ESETP/hyasynth-pcb/hyasynth/hyasynth.kicad_pcb

## KiCad design hyasynth/hyasynth.kicad_pcb (2024-02-29)

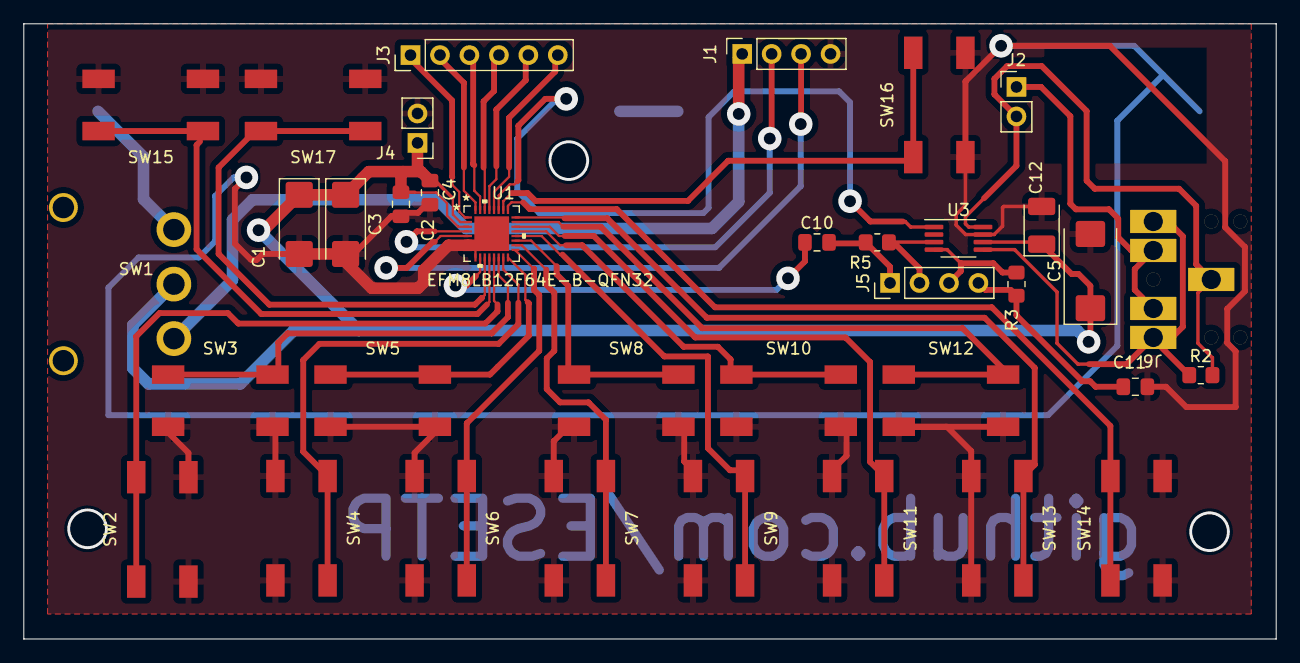
[picture p1: board hyasynth.kicad_pcb from above]

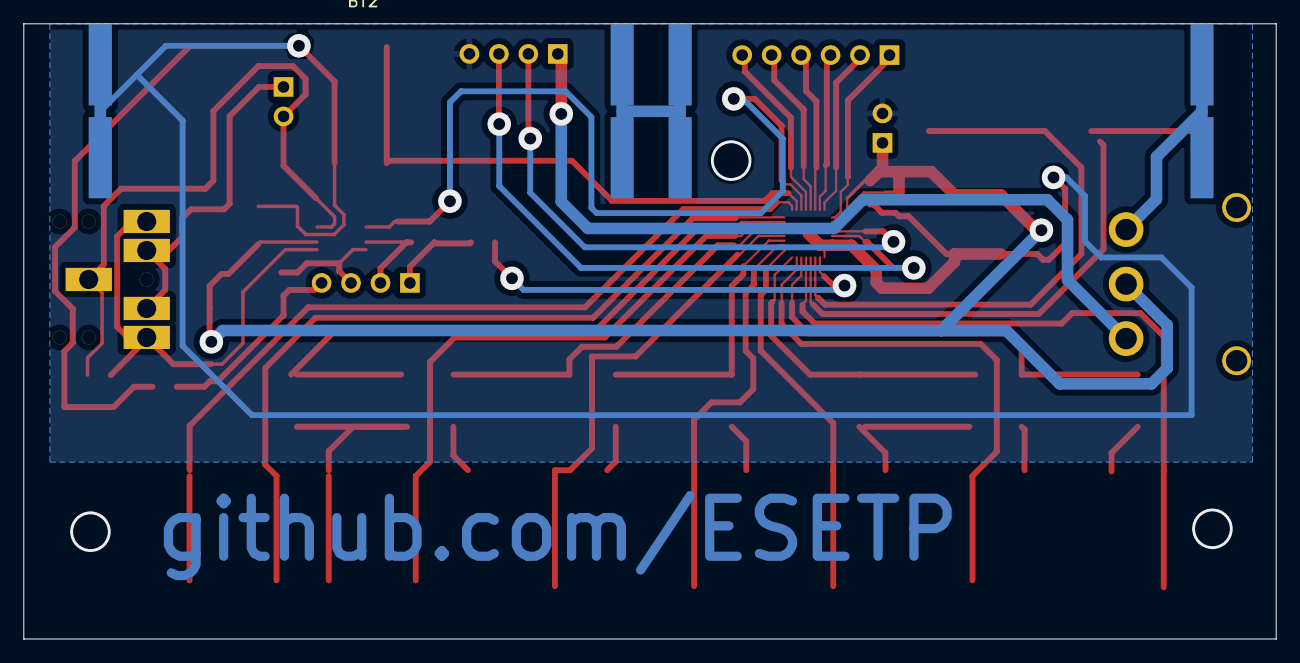
[picture p2: board hyasynth.kicad_pcb from below]

Board: 2 copper layers, 108.0 x 53.0 mm, 38 parts (2 on the bottom side), 38 nets.

Parts:
BT1, BT2: Battery_Cell; Battery AAA
C1, C3: 4.7u; CP_EIA-6032-28_Kemet-C_Pad2.25x2.35mm_HandSolder
C2, C4, C10, C11: 0.1u; C_0805_2012Metric_Pad1.18x1.45mm_HandSolder
C5: 10u; CP_EIA-7343-31_Kemet-D_Pad2.25x2.55mm_HandSolder
C12: 1u; CP_EIA-3528-12_Kemet-T_Pad1.50x2.35mm_HandSolder
J1: Conn_01x04_Male; PinSocket_1x04_P2.54mm_Vertical
J2, J4: Conn_01x02_Male; PinHeader_1x02_P2.54mm_Vertical
J3: Conn_01x06_Male; PinHeader_1x06_P2.54mm_Vertical
J5: Conn_01x04_Male; PinHeader_1x04_P2.54mm_Vertical
J6: AudioJack3_SwitchTR; Jack
R2: 8; R_0805_2012Metric_Pad1.20x1.40mm_HandSolder
R3, R5: R; R_0805_2012Metric_Pad1.20x1.40mm_HandSolder
SW1: Power Switch; Slide Switch
SW2: Low C; SW_Push_hand_solder
SW3: C# Db; SW_Push_hand_solder
SW4: D; SW_Push_hand_solder
SW5: D# Eb; SW_Push_hand_solder
SW6: E; SW_Push_hand_solder
SW7: F; SW_Push_hand_solder
SW8: F# Gb; SW_Push_hand_solder
SW9: G; SW_Push_hand_solder
SW10: G# Ab; SW_Push_hand_solder
SW11: A; SW_Push_hand_solder
SW12: A# Bb; SW_Push_hand_solder
SW13: B; SW_Push_hand_solder
SW14: C; SW_Push_hand_solder
SW15: Down Octave; SW_Push_hand_solder
SW16: Function; SW_Push_hand_solder
SW17: Up Octave; SW_Push_hand_solder
U1: EFM8LB12F64E-B-QFN32
U3: PAM8302AAD; MSOP-8_3x3mm_P0.65mm

Connections:
/A: SW11.2, U1.22 (P1-3)
/A#: SW12.2, U1.23 (P1-2)
/AMP_OUT+: J6.2 (R), J6.5 (T), R2.1, U3.5 (OUT+)
/AMP_OUT-: J2.2, J6.1 (S), R2.2, U3.8 (OUT-)
/AMP_SD: U1.27 (P0-6), U3.1 (~SD)
/B: SW13.2, U1.24 (P1-1)
/C: SW14.2, U1.25 (P1-0)
/C2CLK: J1.2, U1.4 (RSTB/C2CK)
/C2D: J1.3, U1.5 (P3-7/C2D)
/C#: SW3.2, U1.14 (P2-3)
/D: SW4.2, U1.15 (P2-2)
/D#: SW5.2, U1.16 (P2-1)
/DAC: C10.1, U1.10 (P3-0)
/Debug_Power: J1.1, SW1.1 (A)
/Down: SW15.2, U1.12 (P2-5)
/E: SW6.2, U1.17 (P2-0)
/F: SW7.2, U1.18 (P1-7)
/F#: SW8.2, U1.19 (P1-6)
/Function: SW16.2, U1.26 (P0-7)
/G: SW9.2, U1.20 (P1-5)
/G#: SW10.2, U1.21 (P1-4)
/GPIO_1: J3.4, U1.30 (P0-3)
/GPIO_2: J3.3, U1.31 (P0-2)
/GPIO_3: J3.2, U1.32 (P0-1)
/GPIO_4: J3.1, U1.1 (P0-0)
/Low_C: SW2.2, U1.13 (P2-4)
/SPK_OUT-: J2.1, J6.3 (RN), J6.4 (Tn)
/Uart_RX: J3.6, U1.28 (P0-5)
/Uart_TX: J3.5, U1.29 (P0-4)
/Up: SW17.2, U1.11 (P2-6)
/V_pot_in: C10.2, J5.1, R5.1
/V_pot_minus_in: C11.2, J5.4, R3.1
/V_pot_minus_out: J5.3, R3.2, U3.4 (IN-)
/V_pot_out: J5.2, R5.2, U3.3 (IN+)
GND: BT2.2 (-), C1.2, C2.2, C3.2, C4.2, C5.2, C11.1, C12.2, J1.4, J4.2, SW2.1, SW3.1, SW4.1, SW5.1, SW6.1, SW7.1, SW8.1, SW9.1, SW10.1, SW11.1, SW12.1, SW13.1, SW14.1, SW15.1, SW16.1, SW17.1, U1.6 (P3-4), U1.7 (P3-3), U1.8 (P3-2), U1.9 (P3-1), U1.33 (EPAD), U3.7 (GND)
unnamed: BT1.1 (+), SW1.3 (C)
unnamed: BT1.2 (-), BT2.1 (+)
VDD: C1.1, C2.1, C3.1, C4.1, C5.1, C12.1, J4.1, SW1.2 (B), U1.2 (VIO), U1.3 (VDD), U3.6 (VDD)
