ESETP/hyasynth-pcb/(commit log)

2022-01-12 Added Kicad project
    [hyasynth.kicad_pcb, hyasynth.kicad_sch]
2022-01-20 started schematic, micro, power placed, started rst/flashing
    [hyasynth.kicad_sch]
2022-01-22 Added Keybaord to schematic
    [hyasynth.kicad_sch]
2022-01-22 Neatened up schematic
    [hyasynth.kicad_sch]
2022-01-22 Attached footprints to most things
    [hyasynth.kicad_sch]
2022-01-25 Made changes to the schematic to fix bugs
    [hyasynth.kicad_sch]
2022-01-25 Power Amplifier for speaker output
    [hyasynth.kicad_sch]
2022-01-27 Added a jumper
    [hyasynth.kicad_sch]
2022-01-27 Added GPIO and LED
    [hyasynth.kicad_sch]
2022-01-27 Finished inital schematic design, added second amp, rearranged pins
    [hyasynth.kicad_sch]
2022-02-03 Definatly Borked
    [hyasynth.kicad_pcb, hyasynth.kicad_sch]
2022-02-03 Complete Footprint
    [hyasynth.kicad_sch]
2022-02-03 Footprint corrected
    [hyasynth.kicad_pcb, hyasynth.kicad_sch]
2022-02-03 started laying out pcb
    [hyasynth.kicad_pcb, hyasynth.kicad_sch]
2022-02-03 Did very little work
    [hyasynth.kicad_pcb]
2022-02-08 set battery positions, adjusted for caps
    [hyasynth.kicad_pcb, hyasynth.kicad_sch]
2022-02-10 laid out switches, started routing them.
    [hyasynth.kicad_pcb, hyasynth.kicad_sch]
2022-02-24 wired in switches and dac mostly
    [hyasynth.kicad_pcb]
2022-03-10 finished pcb v1
    [hyasynth.kicad_pcb]
2022-03-10 final first draft I swear
    [hyasynth.kicad_pcb]
2022-03-31 Footprint table
2022-03-31 New Footprints
2022-03-31 borrowed new button footprint
    [hyasynth.kicad_pcb, hyasynth.kicad_sch]
2022-04-01 Added jack and switch and repositioned components
    [hyasynth.kicad_pcb, hyasynth.kicad_sch]
2022-04-07 Added thermal relief to battery pads
2022-04-07 Assembly Instructions
2022-04-18 Finished Basic Revision of PCB
    [hyasynth.kicad_pcb, hyasynth.kicad_sch]
2022-04-18 Small changes to the direction tracks are going out from ICs in
    [hyasynth.kicad_pcb]
2022-04-18 Fixed GND via keepout
    [hyasynth.kicad_pcb]
2022-04-19 Schematic Changes
    [hyasynth.kicad_sch]
2022-04-21 Removed Three Vias
    [hyasynth.kicad_pcb]
2022-04-21 Change Footprint for Button
2022-04-21 Change Footprint for Jack and Switch
2022-04-21 tweaks for printing
    [hyasynth.kicad_pcb, hyasynth.kicad_sch]
2022-04-21 updated for new footprints
    [hyasynth.kicad_pcb]
2022-05-17 added headphone resistor, moved amp SD pin, tweak hole size
    [hyasynth.kicad_pcb, hyasynth.kicad_sch]
2022-05-17 added github link to copper
    [hyasynth.kicad_pcb]
2022-05-20 Update AssemblyInstructions.md
    Switched via and resistors and caps position as its easy to bridge power and ground under a cap, which is hard to find with the vias in
2022-05-24 changed link to github not website
    [hyasynth.kicad_pcb]
2024-02-29 Make suitable for fabrication
    - Add load resistor across amp output
    - Add resistor values for amp input
    - Convert edge cuts for drill holes to actual holes
    - Remove debug pad under speaker
    [hyasynth.kicad_pcb, hyasynth.kicad_sch]
